jjamesmartiin/interlock-ergo/pcb/dist/bom_right_choc.csv

Comment | Designator | Footprint | LCSC Part #
Kailh Choc Hotswap Socket CPG135001S30 | SW1 | Kailh_Choc_V1_CPG135001S30 | C5333465
1N4148W | D1 | SOD-123 | C81598
Kailh Choc Hotswap Socket CPG135001S30 | SW2 | Kailh_Choc_V1_CPG135001S30 | C5333465
1N4148W | D2 | SOD-123 | C81598
Kailh Choc Hotswap Socket CPG135001S30 | SW3 | Kailh_Choc_V1_CPG135001S30 | C5333465
1N4148W | D3 | SOD-123 | C81598
Kailh Choc Hotswap Socket CPG135001S30 | SW4 | Kailh_Choc_V1_CPG135001S30 | C5333465
1N4148W | D4 | SOD-123 | C81598
Kailh Choc Hotswap Socket CPG135001S30 | SW5 | Kailh_Choc_V1_CPG135001S30 | C5333465
1N4148W | D5 | SOD-123 | C81598
Kailh Choc Hotswap Socket CPG135001S30 | SW6 | Kailh_Choc_V1_CPG135001S30 | C5333465
1N4148W | D6 | SOD-123 | C81598
Kailh Choc Hotswap Socket CPG135001S30 | SW7 | Kailh_Choc_V1_CPG135001S30 | C5333465
1N4148W | D7 | SOD-123 | C81598
Kailh Choc Hotswap Socket CPG135001S30 | SW8 | Kailh_Choc_V1_CPG135001S30 | C5333465
1N4148W | D8 | SOD-123 | C81598
Kailh Choc Hotswap Socket CPG135001S30 | SW9 | Kailh_Choc_V1_CPG135001S30 | C5333465
1N4148W | D9 | SOD-123 | C81598
Kailh Choc Hotswap Socket CPG135001S30 | SW10 | Kailh_Choc_V1_CPG135001S30 | C5333465
1N4148W | D10 | SOD-123 | C81598
Kailh Choc Hotswap Socket CPG135001S30 | SW11 | Kailh_Choc_V1_CPG135001S30 | C5333465
1N4148W | D11 | SOD-123 | C81598
Kailh Choc Hotswap Socket CPG135001S30 | SW12 | Kailh_Choc_V1_CPG135001S30 | C5333465
1N4148W | D12 | SOD-123 | C81598
Kailh Choc Hotswap Socket CPG135001S30 | SW13 | Kailh_Choc_V1_CPG135001S30 | C5333465
1N4148W | D13 | SOD-123 | C81598
Kailh Choc Hotswap Socket CPG135001S30 | SW14 | Kailh_Choc_V1_CPG135001S30 | C5333465
1N4148W | D14 | SOD-123 | C81598
Kailh Choc Hotswap Socket CPG135001S30 | SW15 | Kailh_Choc_V1_CPG135001S30 | C5333465
1N4148W | D15 | SOD-123 | C81598
Kailh Choc Hotswap Socket CPG135001S30 | SW16 | Kailh_Choc_V1_CPG135001S30 | C5333465
1N4148W | D16 | SOD-123 | C81598
Kailh Choc Hotswap Socket CPG135001S30 | SW17 | Kailh_Choc_V1_CPG135001S30 | C5333465
1N4148W | D17 | SOD-123 | C81598
Kailh Choc Hotswap Socket CPG135001S30 | SW18 | Kailh_Choc_V1_CPG135001S30 | C5333465
1N4148W | D18 | SOD-123 | C81598
Kailh Choc Hotswap Socket CPG135001S30 | SW19 | Kailh_Choc_V1_CPG135001S30 | C5333465
1N4148W | D19 | SOD-123 | C81598
Kailh Choc Hotswap Socket CPG135001S30 | SW20 | Kailh_Choc_V1_CPG135001S30 | C5333465
1N4148W | D20 | SOD-123 | C81598
Kailh Choc Hotswap Socket CPG135001S30 | SW21 | Kailh_Choc_V1_CPG135001S30 | C5333465
1N4148W | D21 | SOD-123 | C81598
Kailh Choc Hotswap Socket CPG135001S30 | SW22 | Kailh_Choc_V1_CPG135001S30 | C5333465
1N4148W | D22 | SOD-123 | C81598
Kailh Choc Hotswap Socket CPG135001S30 | SW23 | Kailh_Choc_V1_CPG135001S30 | C5333465
1N4148W | D23 | SOD-123 | C81598
Kailh Choc Hotswap Socket CPG135001S30 | SW24 | Kailh_Choc_V1_CPG135001S30 | C5333465
1N4148W | D24 | SOD-123 | C81598
Kailh Choc Hotswap Socket CPG135001S30 | SW25 | Kailh_Choc_V1_CPG135001S30 | C5333465
1N4148W | D25 | SOD-123 | C81598
Kailh Choc Hotswap Socket CPG135001S30 | SW26 | Kailh_Choc_V1_CPG135001S30 | C5333465
1N4148W | D26 | SOD-123 | C81598
Kailh Choc Hotswap Socket CPG135001S30 | SW27 | Kailh_Choc_V1_CPG135001S30 | C5333465
1N4148W | D27 | SOD-123 | C81598
Kailh Choc Hotswap Socket CPG135001S30 | SW28 | Kailh_Choc_V1_CPG135001S30 | C5333465
1N4148W | D28 | SOD-123 | C81598
Kailh Choc Hotswap Socket CPG135001S30 | SW29 | Kailh_Choc_V1_CPG135001S30 | C5333465
1N4148W | D29 | SOD-123 | C81598
Kailh Choc Hotswap Socket CPG135001S30 | SW30 | Kailh_Choc_V1_CPG135001S30 | C5333465
1N4148W | D30 | SOD-123 | C81598
Kailh Choc Hotswap Socket CPG135001S30 | SW31 | Kailh_Choc_V1_CPG135001S30 | C5333465
1N4148W | D31 | SOD-123 | C81598
Kailh Choc Hotswap Socket CPG135001S30 | SW32 | Kailh_Choc_V1_CPG135001S30 | C5333465
1N4148W | D32 | SOD-123 | C81598
Kailh Choc Hotswap Socket CPG135001S30 | SW33 | Kailh_Choc_V1_CPG135001S30 | C5333465
1N4148W | D33 | SOD-123 | C81598
Kailh Choc Hotswap Socket CPG135001S30 | SW34 | Kailh_Choc_V1_CPG135001S30 | C5333465
1N4148W | D34 | SOD-123 | C81598
Kailh Choc Hotswap Socket CPG135001S30 | SW35 | Kailh_Choc_V1_CPG135001S30 | C5333465
1N4148W | D35 | SOD-123 | C81598
Kailh Choc Hotswap Socket CPG135001S30 | SW36 | Kailh_Choc_V1_CPG135001S30 | C5333465
1N4148W | D36 | SOD-123 | C81598
Kailh Choc Hotswap Socket CPG135001S30 | SW37 | Kailh_Choc_V1_CPG135001S30 | C5333465
1N4148W | D37 | SOD-123 | C81598
Kailh Choc Hotswap Socket CPG135001S30 | SW38 | Kailh_Choc_V1_CPG135001S30 | C5333465
1N4148W | D38 | SOD-123 | C81598
Kailh Choc Hotswap Socket CPG135001S30 | SW39 | Kailh_Choc_V1_CPG135001S30 | C5333465
1N4148W | D39 | SOD-123 | C81598
