jjamesmartiin/interlock-ergo/pcb/dist/bom_right_mx.csv

Comment | Designator | Footprint | LCSC Part #
Kailh MX Hotswap Socket CPG151101S11 | SW1 | Kailh_MX_CPG151101S11 | C2800547
1N4148W | D1 | SOD-123 | C81598
Kailh MX Hotswap Socket CPG151101S11 | SW2 | Kailh_MX_CPG151101S11 | C2800547
1N4148W | D2 | SOD-123 | C81598
Kailh MX Hotswap Socket CPG151101S11 | SW3 | Kailh_MX_CPG151101S11 | C2800547
1N4148W | D3 | SOD-123 | C81598
Kailh MX Hotswap Socket CPG151101S11 | SW4 | Kailh_MX_CPG151101S11 | C2800547
1N4148W | D4 | SOD-123 | C81598
Kailh MX Hotswap Socket CPG151101S11 | SW5 | Kailh_MX_CPG151101S11 | C2800547
1N4148W | D5 | SOD-123 | C81598
Kailh MX Hotswap Socket CPG151101S11 | SW6 | Kailh_MX_CPG151101S11 | C2800547
1N4148W | D6 | SOD-123 | C81598
Kailh MX Hotswap Socket CPG151101S11 | SW7 | Kailh_MX_CPG151101S11 | C2800547
1N4148W | D7 | SOD-123 | C81598
Kailh MX Hotswap Socket CPG151101S11 | SW8 | Kailh_MX_CPG151101S11 | C2800547
1N4148W | D8 | SOD-123 | C81598
Kailh MX Hotswap Socket CPG151101S11 | SW9 | Kailh_MX_CPG151101S11 | C2800547
1N4148W | D9 | SOD-123 | C81598
Kailh MX Hotswap Socket CPG151101S11 | SW10 | Kailh_MX_CPG151101S11 | C2800547
1N4148W | D10 | SOD-123 | C81598
Kailh MX Hotswap Socket CPG151101S11 | SW11 | Kailh_MX_CPG151101S11 | C2800547
1N4148W | D11 | SOD-123 | C81598
Kailh MX Hotswap Socket CPG151101S11 | SW12 | Kailh_MX_CPG151101S11 | C2800547
1N4148W | D12 | SOD-123 | C81598
Kailh MX Hotswap Socket CPG151101S11 | SW13 | Kailh_MX_CPG151101S11 | C2800547
1N4148W | D13 | SOD-123 | C81598
Kailh MX Hotswap Socket CPG151101S11 | SW14 | Kailh_MX_CPG151101S11 | C2800547
1N4148W | D14 | SOD-123 | C81598
Kailh MX Hotswap Socket CPG151101S11 | SW15 | Kailh_MX_CPG151101S11 | C2800547
1N4148W | D15 | SOD-123 | C81598
Kailh MX Hotswap Socket CPG151101S11 | SW16 | Kailh_MX_CPG151101S11 | C2800547
1N4148W | D16 | SOD-123 | C81598
Kailh MX Hotswap Socket CPG151101S11 | SW17 | Kailh_MX_CPG151101S11 | C2800547
1N4148W | D17 | SOD-123 | C81598
Kailh MX Hotswap Socket CPG151101S11 | SW18 | Kailh_MX_CPG151101S11 | C2800547
1N4148W | D18 | SOD-123 | C81598
Kailh MX Hotswap Socket CPG151101S11 | SW19 | Kailh_MX_CPG151101S11 | C2800547
1N4148W | D19 | SOD-123 | C81598
Kailh MX Hotswap Socket CPG151101S11 | SW20 | Kailh_MX_CPG151101S11 | C2800547
1N4148W | D20 | SOD-123 | C81598
Kailh MX Hotswap Socket CPG151101S11 | SW21 | Kailh_MX_CPG151101S11 | C2800547
1N4148W | D21 | SOD-123 | C81598
Kailh MX Hotswap Socket CPG151101S11 | SW22 | Kailh_MX_CPG151101S11 | C2800547
1N4148W | D22 | SOD-123 | C81598
Kailh MX Hotswap Socket CPG151101S11 | SW23 | Kailh_MX_CPG151101S11 | C2800547
1N4148W | D23 | SOD-123 | C81598
Kailh MX Hotswap Socket CPG151101S11 | SW24 | Kailh_MX_CPG151101S11 | C2800547
1N4148W | D24 | SOD-123 | C81598
Kailh MX Hotswap Socket CPG151101S11 | SW25 | Kailh_MX_CPG151101S11 | C2800547
1N4148W | D25 | SOD-123 | C81598
Kailh MX Hotswap Socket CPG151101S11 | SW26 | Kailh_MX_CPG151101S11 | C2800547
1N4148W | D26 | SOD-123 | C81598
Kailh MX Hotswap Socket CPG151101S11 | SW27 | Kailh_MX_CPG151101S11 | C2800547
1N4148W | D27 | SOD-123 | C81598
Kailh MX Hotswap Socket CPG151101S11 | SW28 | Kailh_MX_CPG151101S11 | C2800547
1N4148W | D28 | SOD-123 | C81598
Kailh MX Hotswap Socket CPG151101S11 | SW29 | Kailh_MX_CPG151101S11 | C2800547
1N4148W | D29 | SOD-123 | C81598
Kailh MX Hotswap Socket CPG151101S11 | SW30 | Kailh_MX_CPG151101S11 | C2800547
1N4148W | D30 | SOD-123 | C81598
Kailh MX Hotswap Socket CPG151101S11 | SW31 | Kailh_MX_CPG151101S11 | C2800547
1N4148W | D31 | SOD-123 | C81598
Kailh MX Hotswap Socket CPG151101S11 | SW32 | Kailh_MX_CPG151101S11 | C2800547
1N4148W | D32 | SOD-123 | C81598
Kailh MX Hotswap Socket CPG151101S11 | SW33 | Kailh_MX_CPG151101S11 | C2800547
1N4148W | D33 | SOD-123 | C81598
Kailh MX Hotswap Socket CPG151101S11 | SW34 | Kailh_MX_CPG151101S11 | C2800547
1N4148W | D34 | SOD-123 | C81598
Kailh MX Hotswap Socket CPG151101S11 | SW35 | Kailh_MX_CPG151101S11 | C2800547
1N4148W | D35 | SOD-123 | C81598
Kailh MX Hotswap Socket CPG151101S11 | SW36 | Kailh_MX_CPG151101S11 | C2800547
1N4148W | D36 | SOD-123 | C81598
Kailh MX Hotswap Socket CPG151101S11 | SW37 | Kailh_MX_CPG151101S11 | C2800547
1N4148W | D37 | SOD-123 | C81598
Kailh MX Hotswap Socket CPG151101S11 | SW38 | Kailh_MX_CPG151101S11 | C2800547
1N4148W | D38 | SOD-123 | C81598
Kailh MX Hotswap Socket CPG151101S11 | SW39 | Kailh_MX_CPG151101S11 | C2800547
1N4148W | D39 | SOD-123 | C81598
