jjamesmartiin/interlock-ergo/cad/interlock_case_choc.scad

// Kailh Choc v1 case. See interlock_case.scad for the implementation.
variant = "choc";
mode    = "assembly";
include <interlock_case.scad>
