jjamesmartiin/interlock-ergo/cad/interlock_case_mx.scad

// Cherry MX case. See interlock_case.scad for the implementation.
variant = "mx";
mode    = "assembly";
include <interlock_case.scad>
