jjamesmartiin/interlock-ergo/cad/interlock_plate_choc.scad

// Kailh Choc v1 switch plate, 1.2mm - the only thickness Choc retention barbs latch into.
variant = "choc";
mode    = "left";
include <interlock_plate.scad>
