jjamesmartiin/interlock-ergo/cad/interlock_plate_mx.scad

// Cherry MX switch plate, 1.5mm.
variant = "mx";
mode    = "left";
include <interlock_plate.scad>
