jjamesmartiin/interlock-ergo/pcb/interlock_ergo_right_choc.kicad_pcb

## KiCad design pcb/interlock_ergo_right_choc.kicad_pcb (2026-11-11)

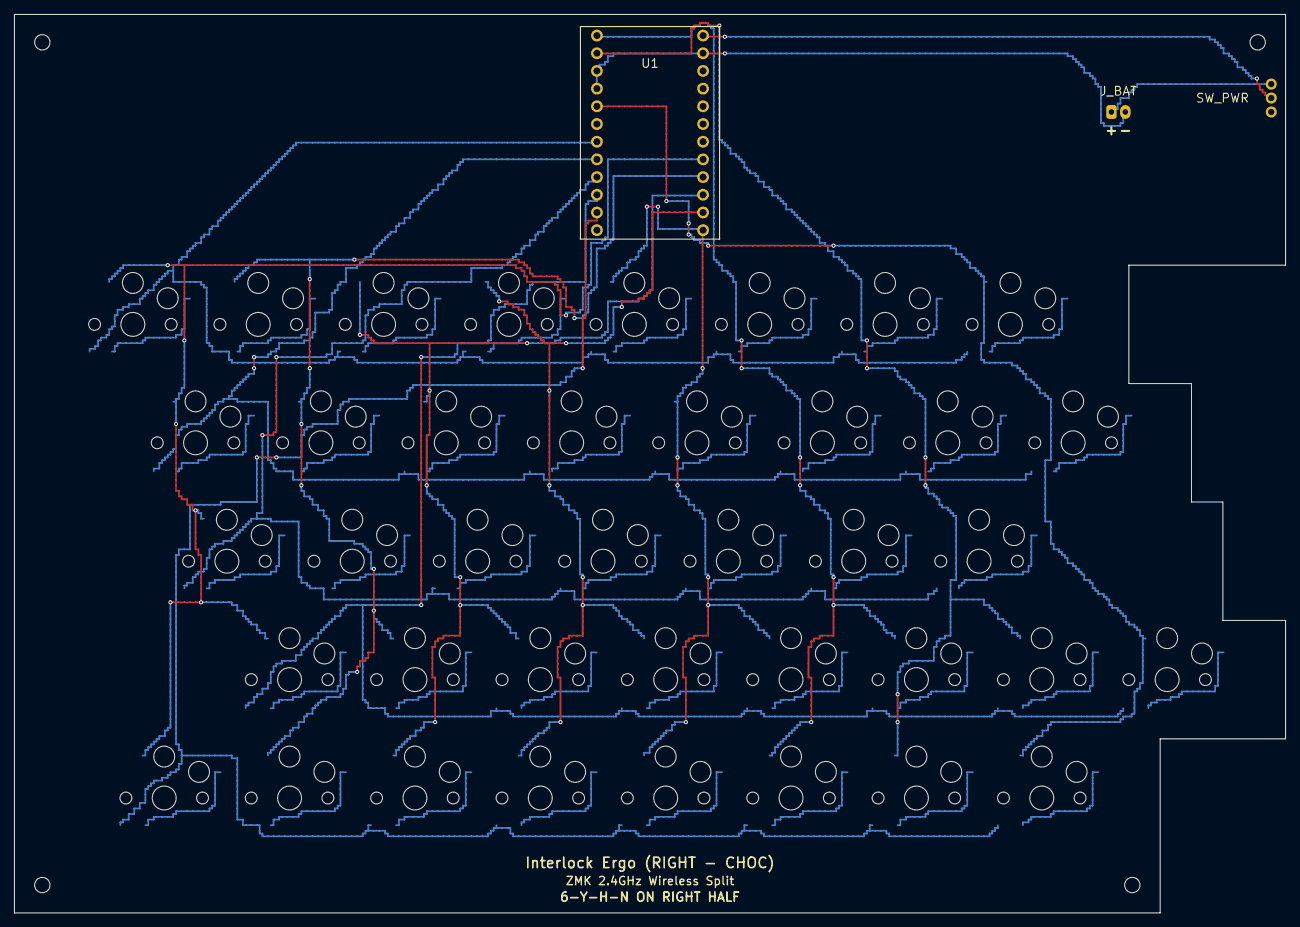
[picture p7: board interlock_ergo_right_choc.kicad_pcb from above]

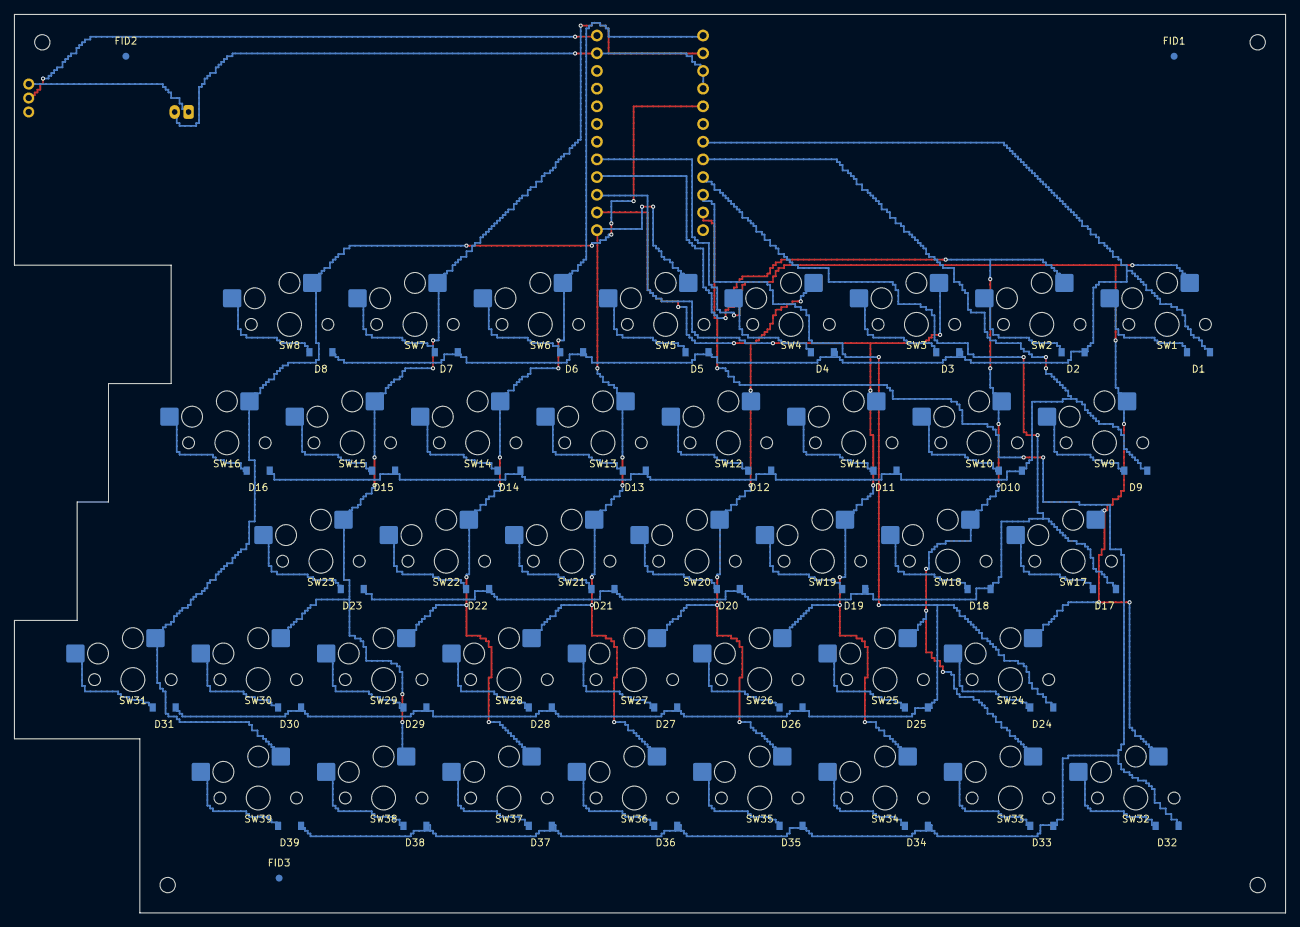
[picture p8: board interlock_ergo_right_choc.kicad_pcb from below]

Board: 2 copper layers, 182.5 x 129.0 mm, 84 parts (81 on the bottom side), 55 nets.

Parts:
D1, D2, D3, D4, D5, D6, D7, D8, D9, D10, D11, D12, D13, D14, D15, D16, D17, D18, D19, D20, D21, D22, D23, D24, D25, D26, D27, D28, D29, D30, D31, D32, D33, D34, D35, D36, D37, D38, D39: D_SOD-123
FID1, FID2, FID3: Fiducial_1mm_Mask2mm
J_BAT: JST_PH_S2B-PH-K_1x02
SW1, SW2, SW3, SW4, SW5, SW6, SW7, SW8, SW9, SW10, SW11, SW12, SW13, SW14, SW15, SW16, SW17, SW18, SW19, SW20, SW21, SW22, SW23, SW24, SW25, SW26, SW27, SW28, SW29, SW30, SW31, SW32, SW33, SW34, SW35, SW36, SW37, SW38, SW39: Kailh_Choc_V1_CPG135001S30
SW_PWR: SlideSwitch_MSK12D19
U1: NiceNano_v2_ProMicro

Connections:
BAT_PLUS: J_BAT.1, SW_PWR.1
COL6: SW1.1, SW9.1, SW17.1, SW24.1, SW32.1, U1.20
COL7: SW2.1, SW10.1, SW18.1, SW25.1, SW33.1, U1.21
COL8: SW3.1, SW11.1, SW19.1, SW26.1, SW34.1, U1.22
COL9: SW4.1, SW12.1, SW20.1, SW27.1, SW35.1, U1.23
COL10: SW5.1, SW13.1, SW21.1, SW28.1, SW36.1, U1.24
COL11: SW6.1, SW14.1, SW22.1, SW29.1, SW37.1, U1.1
COL12: SW7.1, SW15.1, SW23.1, SW30.1, SW38.1, U1.2
COL13: SW8.1, SW16.1, SW31.1, SW39.1, U1.5
GND: J_BAT.2, U1.3, U1.4, U1.14
RAW: SW_PWR.2, U1.13
ROW0: D1.1, D2.1, D3.1, D4.1, D5.1, D6.1, D7.1, D8.1, U1.7
ROW1: D9.1, D10.1, D11.1, D12.1, D13.1, D14.1, D15.1, D16.1, U1.8
ROW2: D17.1, D18.1, D19.1, D20.1, D21.1, D22.1, D23.1, U1.9
ROW3: D24.1, D25.1, D26.1, D27.1, D28.1, D29.1, D30.1, D31.1, U1.10
ROW4: D32.1, D33.1, D34.1, D35.1, D36.1, D37.1, D38.1, D39.1, U1.11
SW_D_R0_C0: D1.2, SW1.2
SW_D_R0_C1: D2.2, SW2.2
SW_D_R0_C2: D3.2, SW3.2
SW_D_R0_C3: D4.2, SW4.2
SW_D_R0_C4: D5.2, SW5.2
SW_D_R0_C5: D6.2, SW6.2
SW_D_R0_C6: D7.2, SW7.2
SW_D_R0_C7: D8.2, SW8.2
SW_D_R1_C0: D9.2, SW9.2
SW_D_R1_C1: D10.2, SW10.2
SW_D_R1_C2: D11.2, SW11.2
SW_D_R1_C3: D12.2, SW12.2
SW_D_R1_C4: D13.2, SW13.2
SW_D_R1_C5: D14.2, SW14.2
SW_D_R1_C6: D15.2, SW15.2
SW_D_R1_C7: D16.2, SW16.2
SW_D_R2_C0: D17.2, SW17.2
SW_D_R2_C1: D18.2, SW18.2
SW_D_R2_C2: D19.2, SW19.2
SW_D_R2_C3: D20.2, SW20.2
SW_D_R2_C4: D21.2, SW21.2
SW_D_R2_C5: D22.2, SW22.2
SW_D_R2_C6: D23.2, SW23.2
SW_D_R3_C0: D24.2, SW24.2
SW_D_R3_C1: D25.2, SW25.2
SW_D_R3_C2: D26.2, SW26.2
SW_D_R3_C3: D27.2, SW27.2
SW_D_R3_C4: D28.2, SW28.2
SW_D_R3_C5: D29.2, SW29.2
SW_D_R3_C6: D30.2, SW30.2
SW_D_R3_C7: D31.2, SW31.2
SW_D_R4_C0: D32.2, SW32.2
SW_D_R4_C1: D33.2, SW33.2
SW_D_R4_C2: D34.2, SW34.2
SW_D_R4_C3: D35.2, SW35.2
SW_D_R4_C4: D36.2, SW36.2
SW_D_R4_C5: D37.2, SW37.2
SW_D_R4_C6: D38.2, SW38.2
SW_D_R4_C7: D39.2, SW39.2
