jjamesmartiin/interlock-ergo/(commit log)

2026-11-05 Initial commit: Interlock Ergo split keyboard with 6YHN on right half, ZMK 2.4GHz dongle, and interlocking CAD
    [dongle_case.scad, interlock_case.scad, interlock_dock.scad]
2026-11-05 Remediate audit findings: split KiCad PCBs (Choc & MX), plate STLs, ZMK split config fixes, and ground-truth pinout
    [bom_left_choc.csv, bom_left_mx.csv, bom_right_choc.csv, bom_right_mx.csv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]
2026-11-05 docs: add comprehensive BOM sourcing directory with verified vendor links and public release README
2026-11-05 fix(pcb,cad,ci): eliminate matrix shorts, map all MCU pads, align magnets to 0mm, and pin ZMK v0.2
    [bom_left_choc.csv, bom_left_mx.csv, bom_right_choc.csv, bom_right_mx.csv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]
2026-11-05 feat(nix): add flake.nix, shell.nix, zmk-nix firmware builders, and nix build targets for CAD and PCB
2026-11-05 Fix every production blocker: route the PCBs, rebuild the case, publish the product docs
    Adversarial review of the current tree found three classes of defect that made
    this unshippable. All three are now closed and gated.
    PCBs (was: 90-107 DRC violations, 38-44 unconnected pads, no fab output)
    - Replace the hand-drawn bus diagonals with a real two-layer grid router:
    0.4mm grid, 0.25mm tracks, 0.6/0.3mm vias, per-layer net-owned occupancy with
    an orthogonal-neighbour guard so 0.2mm clearance is a construction property.
    Nets grow nearest-terminal-first: local switch->diode links, ROW0-4, columns,
    encoder, power tree.
    - All four boards: 0 violations, 0 unconnected. Gerbers/BOM/CPL emit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
    [bom_left_choc.csv, bom_left_mx.csv, dongle_case.scad, interlock_case.scad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]
2026-11-05 Pin fabrication timestamps so pcb/dist is reproducible
    KiCad stamps a creation date into every gerber, the .gbrjob and the DRC report,
    so any rebuild produced byte-different artifacts and left the tree dirty even when
    nothing changed electrically. Pin them on the way out; two runs from identical
    sources are now byte-identical (verified over all four zips and reports).
    [interlock_ergo_left_choc-B_Courtyard.gbr, interlock_ergo_left_choc-B_Cu.gbl, interlock_ergo_left_choc-B_Mask.gbs, interlock_ergo_left_choc-B_Silkscreen.gbo, interlock_ergo_left_choc-Edge_Cuts.gm1, interlock_ergo_left_choc-F_Courtyard.gbr, interlock_ergo_left_choc-F_Cu.gtl, interlock_ergo_left_choc-F_Mask.gts]
2026-11-05 Decouple the matrix test from generated STLs
    tests/test_matrix.js asserted the eleven STL exports exist, so it failed on a
    fresh clone (cad/dist is gitignored and must be built first) and it duplicated a
    weaker version of what tests/test_models.js already proves. Drop the check and
    let the mesh gate own it.
2026-11-06 Add mesh-sampling and process-limit gates; fix the encoder hole and the order quantity
    Two more classes of defect were only findable by hand. Both are now automatic.
    Encoder hole (real bug this gate found first):
    - interlock_plate.scad cut the EC11 body clearance with `center = true`, which
    centres Z as well, so the cut only reached z=0.6 of a 1.2mm plate. The encoder
    body would have bottomed out on the plate with no way to see it in a dimension
    check. Anchor the cut on the plate mid-plane.
    Mesh-sampling gate (tests/test_alignment.js):
    - Dimension checks cannot tell where a feature *is*, only how big the part is. This
    ray-casts the exported STLs (tilted Moller-Trumbore, so samples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
    [interlock_plate.scad]
2026-11-06 Fix both hotswap footprints: the solder pads were on the switch pins
    Checked against marbastlib (SW_choc_v1_HS_CPG135001S30_1u,
    SW_MX_HS_CPG151101S11) and ergogen's choc.js / mx.js, which agree with each other
    and disagree with what this generator was emitting.
    A Kailh hotswap socket does not solder to the switch pin. Its body sits in a 3.0mm
    clearance hole at the pin and its two tabs land ~3.275mm (Choc) / ~3.3mm (MX)
    OUTBOARD of it. The generator had SMD pads directly on the pin positions and no pin
    clearance holes at all. That is electrically perfect - the netlist check passed, DRC
    passed, the matrix works in simulation - and mechanically impossible: no socket
    could be soldered to it. Th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
    [interlock_ergo_left_choc.kicad_pcb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]
2026-11-06 Encoder: add the two mounting-post slots the EC11 stands on
    Third defect of the same class, found by checking the footprint against
    marbastlib's ROT_Alps_EC11E-Switch instead of trusting the generator.
    An Alps EC11E has two 2.8 x 1.5mm slotted mounting posts at x = +/-5.6 in addition
    to its five pins. The footprint had none, so the encoder body would have stood on
    its own mounting legs and never seated on the board - the pins would not reach
    their holes. DRC cannot see this and neither can the netlist check: the footprint
    is electrically complete and mechanically unusable.
    Also aligned A/B/C to the reference: y = +7.5 on 2.5mm pitch (was +7.0), 2.0mm
    pads (was 1.8).
    tests/test_alignment.j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
    [interlock_ergo_left_choc.kicad_pcb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]
2026-11-06 Apply the verified part dimensions; three assumptions were wrong
    Checked every mechanical dimension against a primary source. Sources and confidence
    are now recorded in docs/part-dimensions.md so the next change can be checked
    against a drawing rather than against memory.
    Corrected (each of these was baked into CAD):
    - XIAO nRF52840 is 20.955 x 17.78 x 1.6 mm, not 21 x 17.5. 17.5 is the older XIAO;
    the dongle pocket would not have taken the board. Seeed's official KiCad Edge.Cuts.
    USB-C shell sits ~1.4 mm inboard of the short edge, so the window moved up to the
    connector height instead of the old whole-module height, and the case is 9.3 mm.
    - The documented 402030 is a 200 mAh cell, n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
    [dongle_case.scad, interlock_case.scad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]
2026-11-07 Make the firmware build, and fix the doc and packaging defects the audit missed
    The flake had never been built. Two of the three shields were broken and one
    document was lying about the hardware.
    Firmware:
    - zephyrDepsHash was stale for all three targets, so none of them could build.
    Replaced with the hash the pinned west manifest actually produces.
    - The dongle's ZMK_KEYBOARD_NAME was "Interlock Ergo Dongle" (21 chars); Zephyr
    asserts BT_DEVICE_NAME_MAX (16 incl. NUL), so the dongle alone failed to
    compile. Now "Interlock Ergo", with a length assertion in test_matrix.js -
    no other gate can see this class of bug.
    - ZMK v0.2's central_bas_proxy.c passes a LISTIFY index as a `void *`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
    [interlock_ergo_left_choc.kicad_pcb, interlock_ergo_left_mx.kicad_pcb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]
2026-11-10 Close every remaining audit item, and fix four defects no gate could see
    The audit's P0/P1 list is closed: two items fixed in code, three accepted with
    the exact change that would close them, the rest documented where a builder will
    actually read it. Chasing the fixes turned up four live defects, all of which
    would have been found by a buyer rather than by CI.
    Defects:
    - The USB-C window never opened the case. The through-cut started 1.3mm inside
    the wall and left a membrane over the port, so no cable could ever have been
    plugged in: the board could not be flashed or charged once built. It is now a
    real through-cut plus a 13 x 7.2mm exterior relief pocket 2.4mm deep, because
    the con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
    [bom_left_choc.csv, bom_left_mx.csv, bom_right_choc.csv, bom_right_mx.csv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]
2026-11-11 Give the board a stepped silhouette, and pull the layout back onto GH60 columns
    Two changes, one root: the key field is the source of truth, so the outline and the
    column count both derive from it now.
    Silhouette:
    - The PCB, plate and case are built from one band stack - the controller bay, one
    band per key row, the bottom margin - instead of three rectangles with 8-30mm of
    dead copper down alternating sides of every row. The outer edge steps with the row
    stagger (9 / 13.5 / 22.5 / 4.5 mm on the left Choc half) and the seam face stays a
    straight plane, because it is the joint and the dovetail needs one.
    - generate_pcb.js traces Edge.Cuts from those bands, and the router's edge keep-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
    [bom_left_choc.csv, bom_left_mx.csv, interlock_case.scad, interlock_ergo_left.kicad_sch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]
2026-11-11 Align right half to 8-column DZ60 layout, fix hero render orientation, and add AI disclaimer
    - Convert right half from 9 to 8 columns (cols_right = 8), matching a DZ60
    split down the middle (between 5 and 6), with 68 keys total (29 L + 39 R).
    - Drop 65% nav cluster (Home, End, PgUp, PgDn) and properly align inverted-T
    arrow cluster: Up at Col 12 directly over Down at Col 12, flanked by Left
    at Col 11 (under RShift) and Right at Col 13 (under Delete).
    - Fix camera basis vector in cad/render_preview.js to prevent horizontal mirroring
    of renders, update leftW docking offset to 6 columns, and fix right plate offset.
    - Add AI development disclaimer to README.md.
    - Regenerate all 4 KiCad P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
    [bom_right_choc.csv, bom_right_mx.csv, interlock_ergo_right.kicad_sch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]
